IamfromSpace/rust-cycle-housing/housing.png

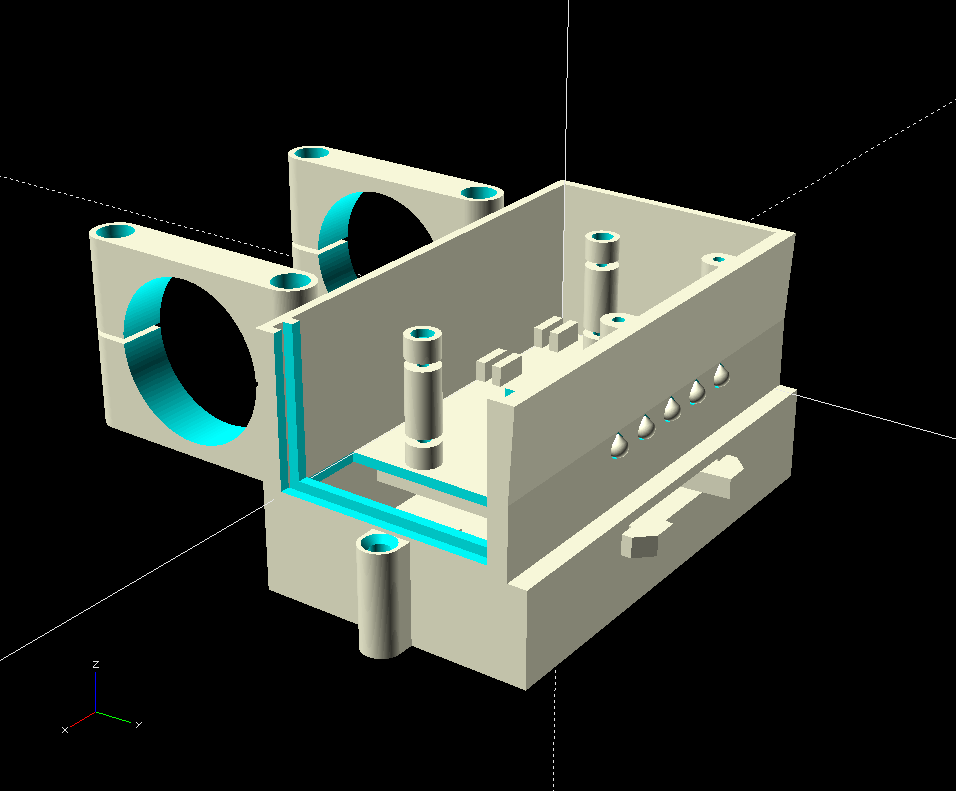
housing.png
