IamfromSpace/rust-cycle-housing/housing_exploded.png

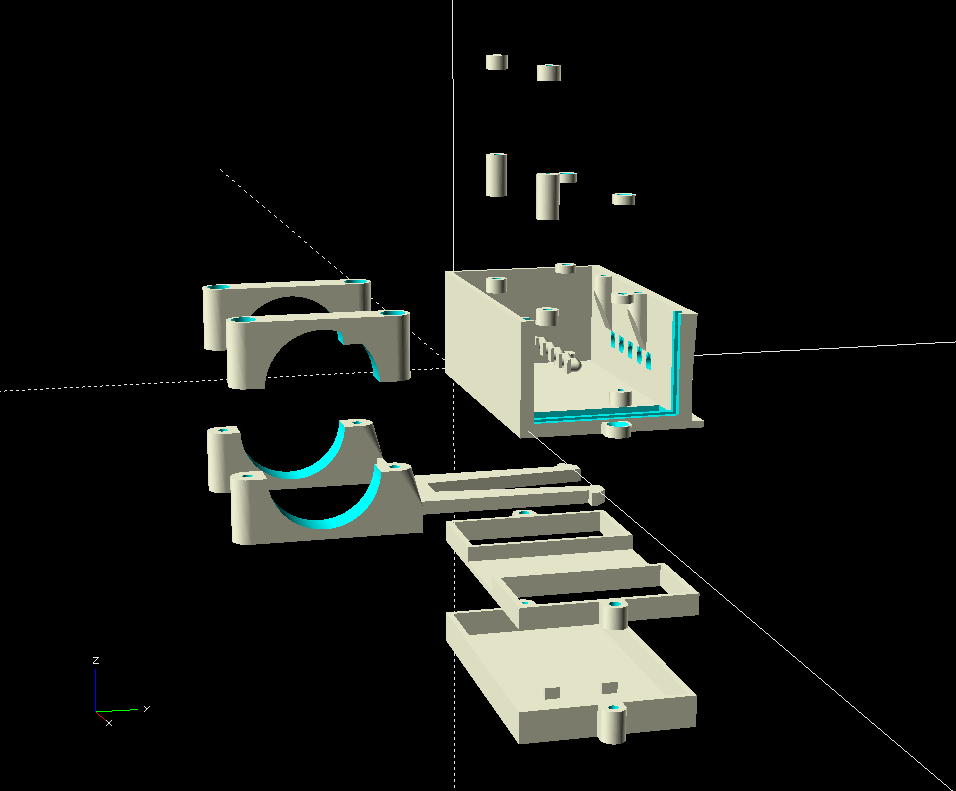
housing_exploded.png
