IamfromSpace/rust-cycle-housing/(commit log)

2021-06-06 Lay the foundation for the pi, button shim, and adapter board to be mounted on rods.
    [housing.scad]
2021-06-07 Add button openings.
    [housing.scad]
2021-06-07 Add a display holder, name all variables when entered, and set the origin to be the _inside_ corner of the housing.
    [housing.scad]
2021-06-10 Add small inserts to hold the display in place.
    [housing.scad]
2021-06-10 Make a weird little box for the battery.
    [housing.scad]
2021-06-14 Fix inner distances and better abstract around them (still more todo here).
    [housing.scad]
2021-06-15 Abstract the button wall out into its own module.
    [housing.scad]
2021-06-15 Add space for SD card on the left side of the board.
    [housing.scad]
2021-06-15 Move tolerance to the outside of the origin.
    [housing.scad]
2021-06-17 Add place for the GPS board.
    [housing.scad]
2021-06-17 Add a cutout section to connect the battery and main housing in an open cavity.
    [housing.scad]
2021-06-17 Use small guards instead of full guards in prep for aligning the two housings.
    [housing.scad]
2021-06-17 Ensure that the battery and main housings line up.
    [housing.scad]
2021-06-21 Add a generic screw housing module.
    [housing.scad]
2021-06-22 Add screw holes to attach the primary and battery housing.
    [housing.scad]
2021-06-22 Add actual measurements.
    [housing.scad]
2021-06-22 Fix an issue with display guide position and add TODO.
    [housing.scad]
2021-06-22 Allow specific component selection.
    [housing.scad]
2021-06-22 Fix unaligned screws.
    [housing.scad]
2021-06-22 Backoff thread engagement a bit.
    [housing.scad]
2021-06-23 Add a bar clamp module.
    [housing.scad]
2021-06-23 Add bottom bar clamps to the battery housing.
    [housing.scad]
2021-06-23 Enable stacking of the bar clamp so that users don't need to know how to offset it if they want to render them together.
    [housing.scad]
2021-06-23 Add top of the bar clamp components on rendering, or as single selection.
    [housing.scad]
2021-06-23 By default, make the screw housing flat against the plane where x=0.
    [housing.scad]
2021-06-23 Add a gap on the top and bottom of the bar clamps to ensure there's compression.
    [housing.scad]
2021-06-25 Add a series of TODOs based on riding with the housing.
    [housing.scad]
2021-06-26 Fix an issue where the gap between the bar clamps was less than expected.
    [housing.scad]
2021-06-26 Reduce the wall height slightly to be a bit more accurate.
    [housing.scad]
2021-06-26 Fix issue where the display protrusion wasn't quite accurate.
    [housing.scad]
2021-06-27 Fix an issue where the buttons were offset to far to the riders right.
    [housing.scad]
2021-06-27 Make button offset easier to measure.
    [housing.scad]
2021-06-27 Instead of guides or pips to support the display board, use screw holes and extend backwards with minimum overhang.
    [housing.scad]
2021-06-28 Instead of using mounting rods on both the top and bottom for the pi and adapter, use screw-in spacers on one side so things hold in place better.
    [housing.scad]
2021-06-28 Add images of the housing.
2021-06-28 Remove TODO that should be TODONE based on a combo of previous work.
    [housing.scad]
2021-06-30 Set shim height by the center of the button rather than the bottom of the board.
    [housing.scad]
2021-06-30 Add a helper module for defining keyed horizontally-printable buttons.
    [h_buttons.scad]
2021-06-30 Use keyed buttons so buttons are easily pressable.
    [housing.scad]
2021-06-30 Round the top of the button for fewer sharp edges.
    [h_buttons.scad]
2021-06-30 More accurately determine the button depth.
    [housing.scad]
2021-06-30 Fix an issue where buttons were too low (using the solder_clearance, rather than the possibly larger pi_offset_z).
    [housing.scad]
2021-06-30 Increase button size and the impression thickness.
    [housing.scad]
2021-06-30 Decrease the amount of tolerance in the backside of the buttons.
    [housing.scad]
2021-07-01 Extend the button wall all the way to the left and right so that the extended top looks more natural.
    [housing.scad]
2021-07-01 Add left and back walls, and a slot for the right side wall.
    [housing.scad]
2021-07-01 Fix an issue where the battery housing screws were every so slightly shifted.
    [housing.scad]
2021-07-01 Fix pi placement tolerances so that the tolerance goes into the gps offset and remove tolerance that's already account for in the buttons to the wall.
    [housing.scad]
2021-07-01 Add TODO.
    [housing.scad]
2021-07-01 Tighten down the board screw tolerance ever so slightly.
    [housing.scad]
2021-07-02 Widen the area to hold the right side wall by the tolerance.
    [housing.scad]
2021-07-02 Move tolerance into inner_y for consistency with inner_x.
    [housing.scad]
2021-07-02 Fix incorrect handling of tolerance in the power cutout postiion.
    [housing.scad]
2021-07-02 Fix error where inner_x was used when joining_plane_x should have been.
    [housing.scad]
2021-07-02 Allow the screw_housing module to support any number of connecting shafts that do not engage the threads. This is useful if the screw passes through multiple circuit boards that would otherwise just 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
    [housing.scad]
2021-07-02 Screw the pi into the main housing instead of it riding on rods.
    [housing.scad]
2021-08-27 Reduce the size of the board screw minor radius.
    [housing.scad]
2021-08-29 Fix incorrect indentation.
    [housing.scad]
2021-08-29 Add a middle housing section that creates a slot for cantilever snaps to the bar clamps (currently TODO).
    [housing.scad]
2021-08-29 Attach the bar clamps to cantilevers for easier removal, freeing them from the battery housing.
    [housing.scad]
2021-08-29 Fine tune the cantilever, less overhang and reinforce the base, so the arms bend instead of it.
    [housing.scad]
